alex-mous/Binary-Clock/README.md

# Binary (Base 2) Alarm Clock

### Conversion of a classic two-bell alarm clock into a futuristic binary (base 2) clock using a Circuit Playground Express and an Equity #13014
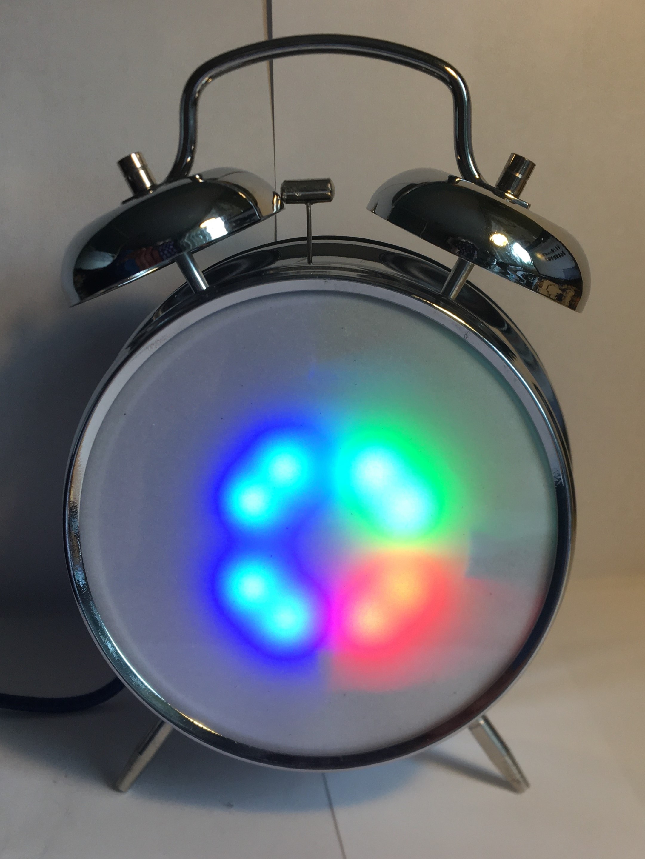
[picture p1: Assembly/10_40.JPG]
Completed Binary Clock project


### Parts and Materials
- Equity Two Bell Alarm Clock (#13014)
- 1Hz Timebase Circuit (taken from a clock circuit) - although I used a different circuit, you probably can adapt the one from the clock

- Circuit Playground Express
- Right-angle Micro USB to USB Type A Cable
- 5V USB Phone Charger
- Electronic components and wire as shown in the [wiring diagram](/Assembly/Wiring.pdf) and [BOM](/Assembly/BOM.csv)
- Files, screwdrivers, and soldering equipment
- Double sided tape and glue
- Three circle of vellum paper the same size as the alarm clock's face (3 13/16 inches)

### Software Setup
To setup your Circuit Playground Express, please see the Adafruit website. For this project, you will need to be able to upload code to it via the Arduino IDE.

Open the file main.ino in Arduino and upload it to the Circuit Playground Express.

### Hardware Setup

#### Disassembly
Dismantle the alarm clock by removing the screws on the back as shown in the picture below. Then continue to remove parts from it until only the metal shell is left. Also, desolder the connections to the clock mechanism and put it aside, marking which wires are for positive, negative and signals; we will be using it later to connect.

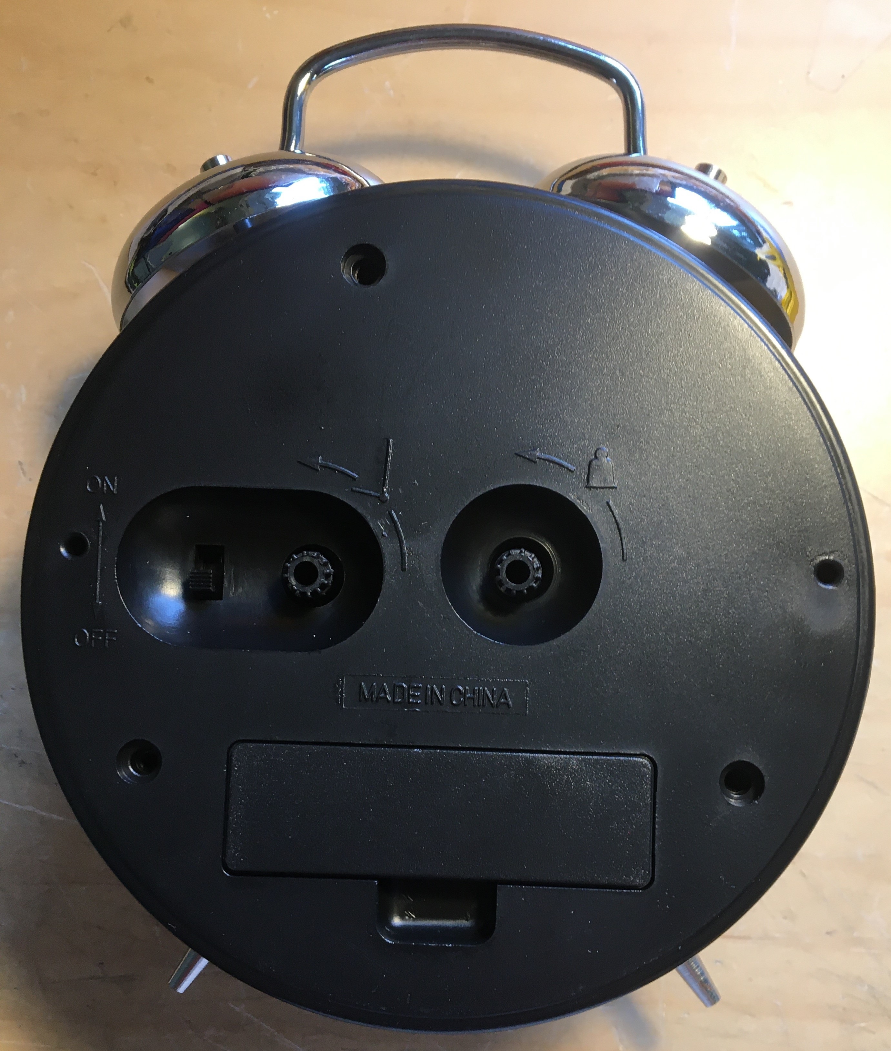
[picture p2: Assembly/Back_before.JPG]
Filed area out of the back of the case


There's an excellent guide on iFixit if you need more complete instructions for [disassembling it](https://www.ifixit.com/Guide/Equity+Alarm+Clock+13014+Clock+Hands+Replacement/33113).

#### Modifications
You will need to file the inner case to make it large enough so that the wires will all fit easily. Also, it is helpful to file a slot for the USB cable to go through in the front of the main plastic part. Finally, create a hole in the back of the case for the USB cable. Please see the picture below for where and how much to remove:

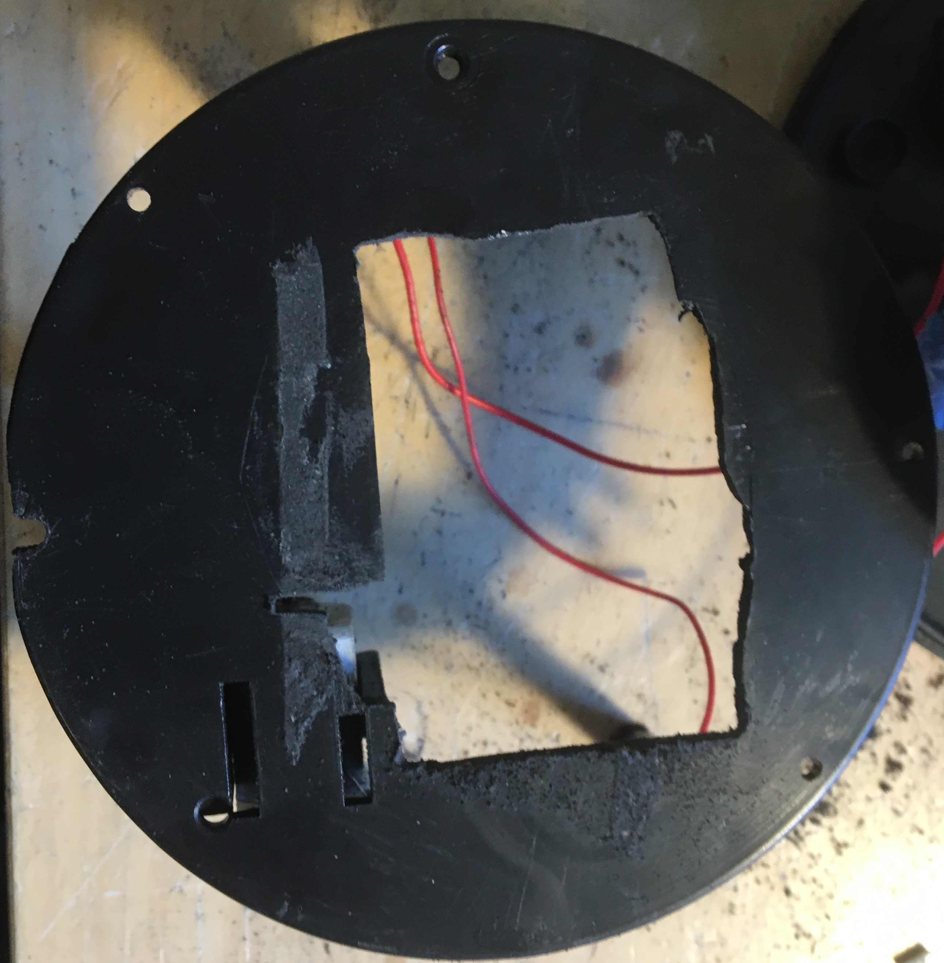
[picture p3: Assembly/Filed_back.JPG]
Filed area out of the back of the case


#### Creating the Timer Circuit
To create the timer circuit, first disassemble the clock case (there are three tabs that you'll need to pry up to get the lid off). Then remove the gears and other parts until you have the circuit separated.

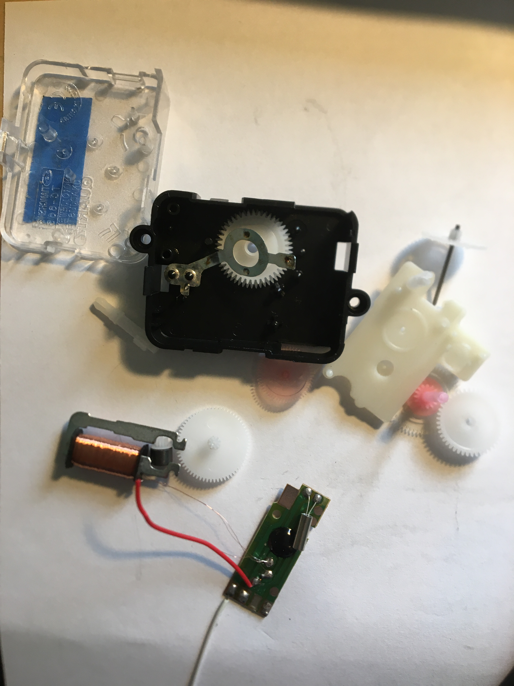
[picture p4: Assembly/Clock_circuit_disassembled.JPG]
Clock unit disassembled with gears and circuit removed


Next, solder up the circuit at shown in the wiring diagram with the connections highlighted below to the left. The diodes need to be connected to the coil output, and the power wires need to be connected to the resistors:

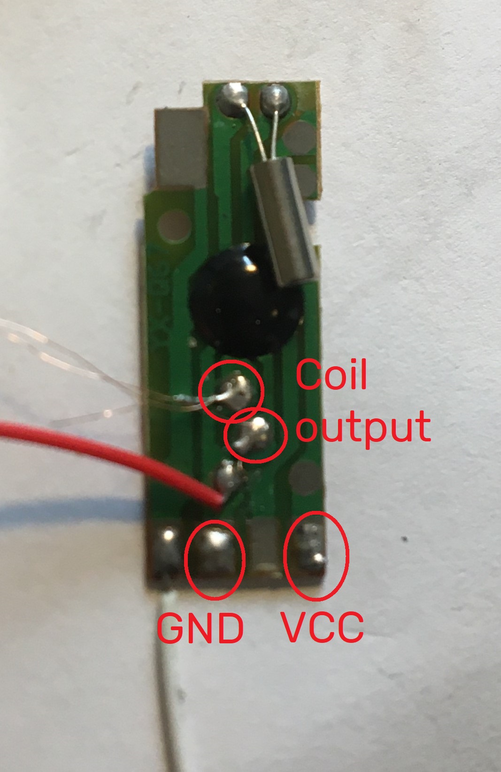
[picture p5: Assembly/Clock_circuit_adapted_new.JPG]
Clock circuit with adaptations
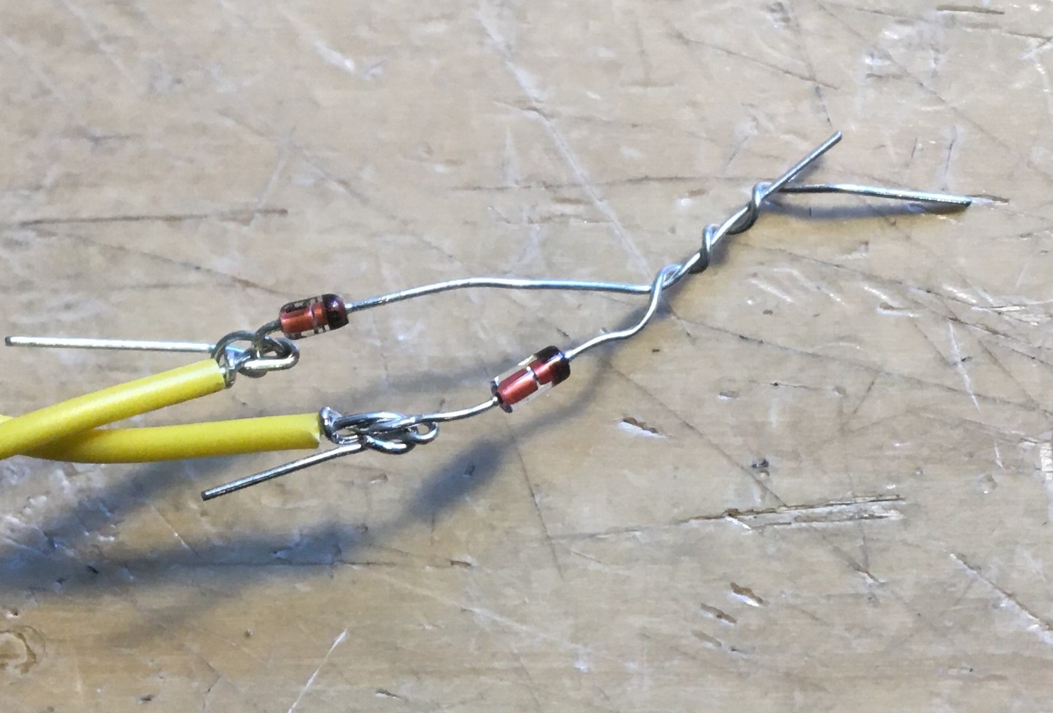
[picture p6: Assembly/Clock_circuit_output.JPG]
Clock circuit pulse output connection
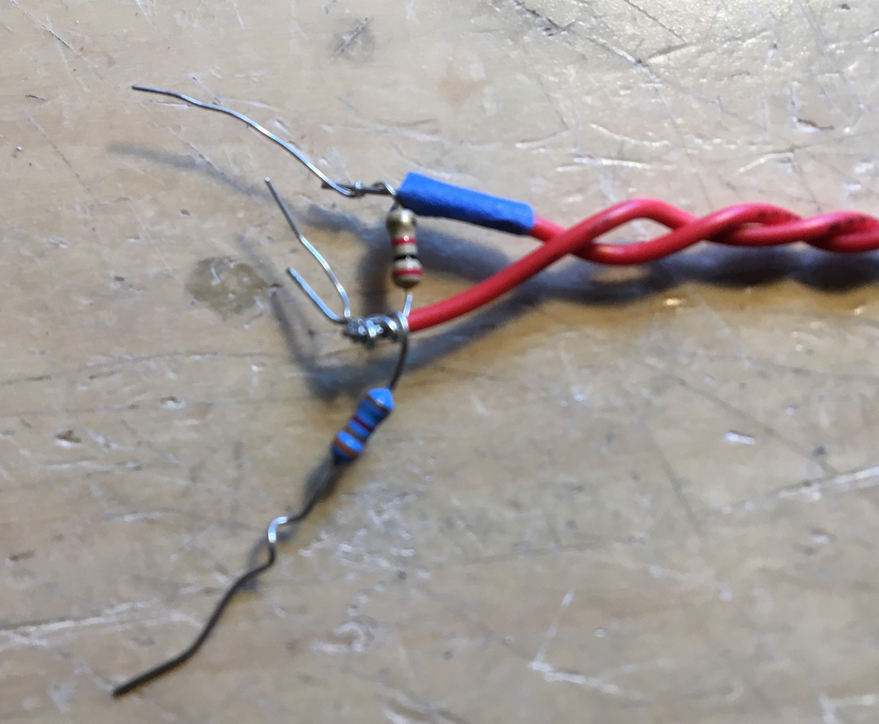
[picture p7: Assembly/Clock_circuit_voltage_supply.JPG]
Clock circuit voltage input lines


#### Wiring
Solder together the Circuit Playground Express board as shown below (reference the pictures with the <a href="/Assembly/Wiring.pdf">Wiring diagram</a>)

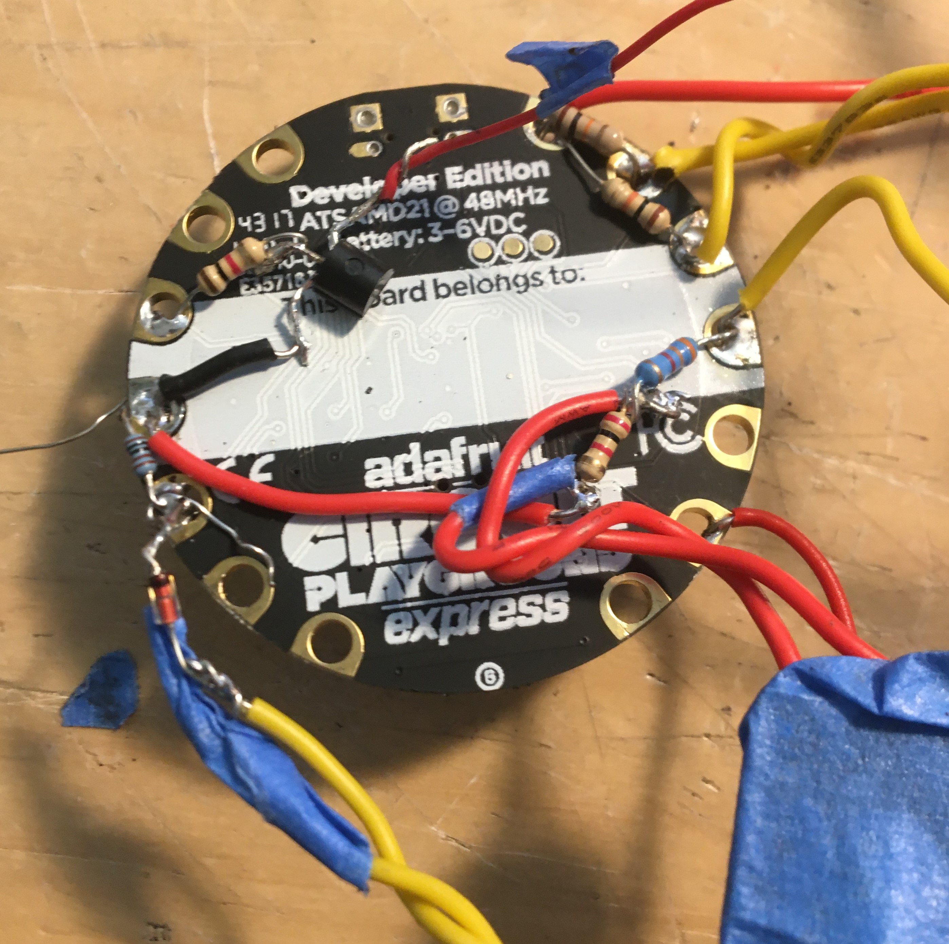
[picture p8: Assembly/Wired_circuit_board.JPG]
Circuit Playground Express component wiring


Next, glue in the switches as shown below and solder them up.

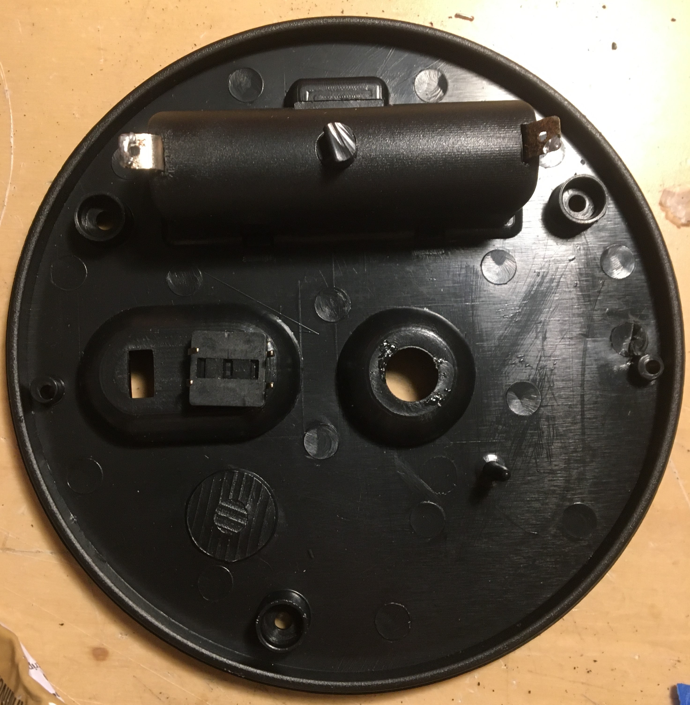
[picture p9: Assembly/Glueing_switches.JPG]
Glue the buttons into place
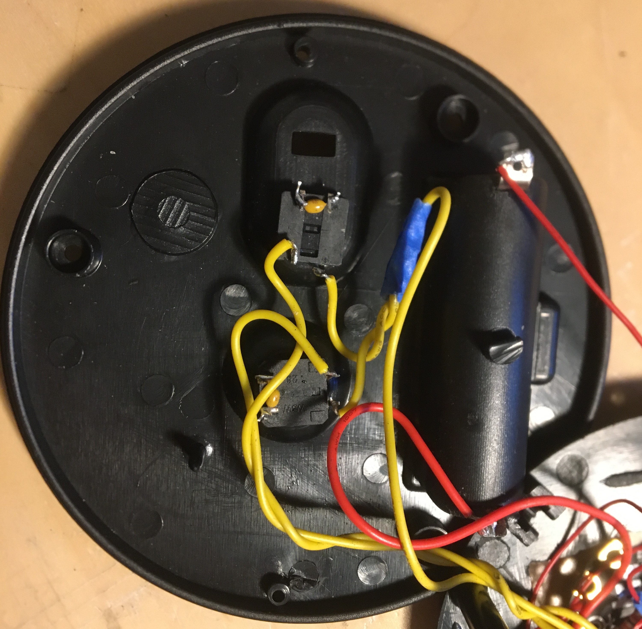
[picture p10: Assembly/Switch_wiring.JPG]
Buttons wiring to the main circuit


Then, solder up the motor and alarm switch using the original wire.

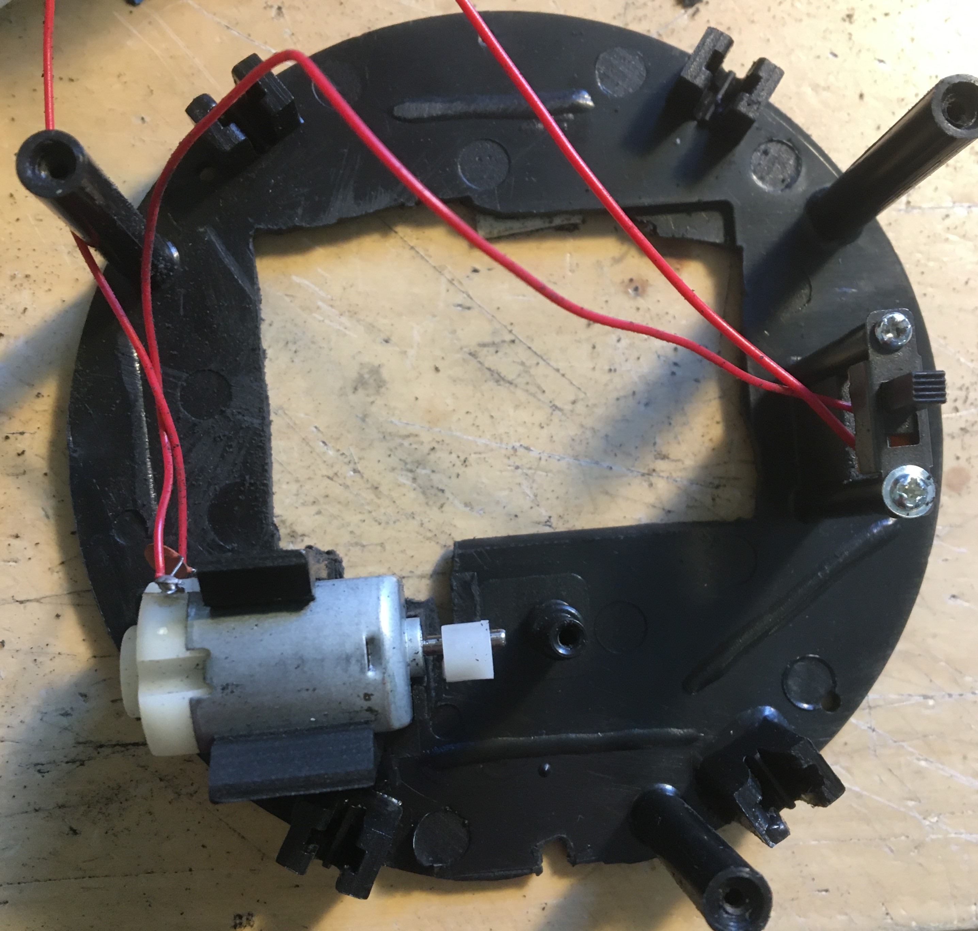
[picture p11: Assembly/Motor_wiring.JPG]
Motor wiring


Finally, solder up the rest of the project as shown below and in the wiring diagram.

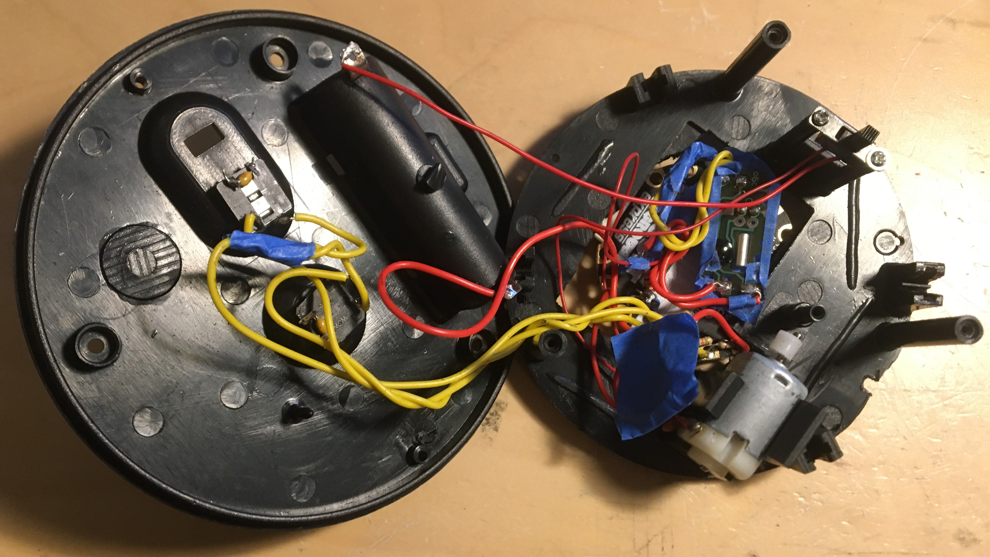
[picture p12: Assembly/Complete_circuit_installed.JPG]
Circuit completely assembled


#### Final Assembly
Now attach the Circuit Playground Express to the front with double sided tape. Plug in the USB cable, and route it through the case and out the hole in the back.

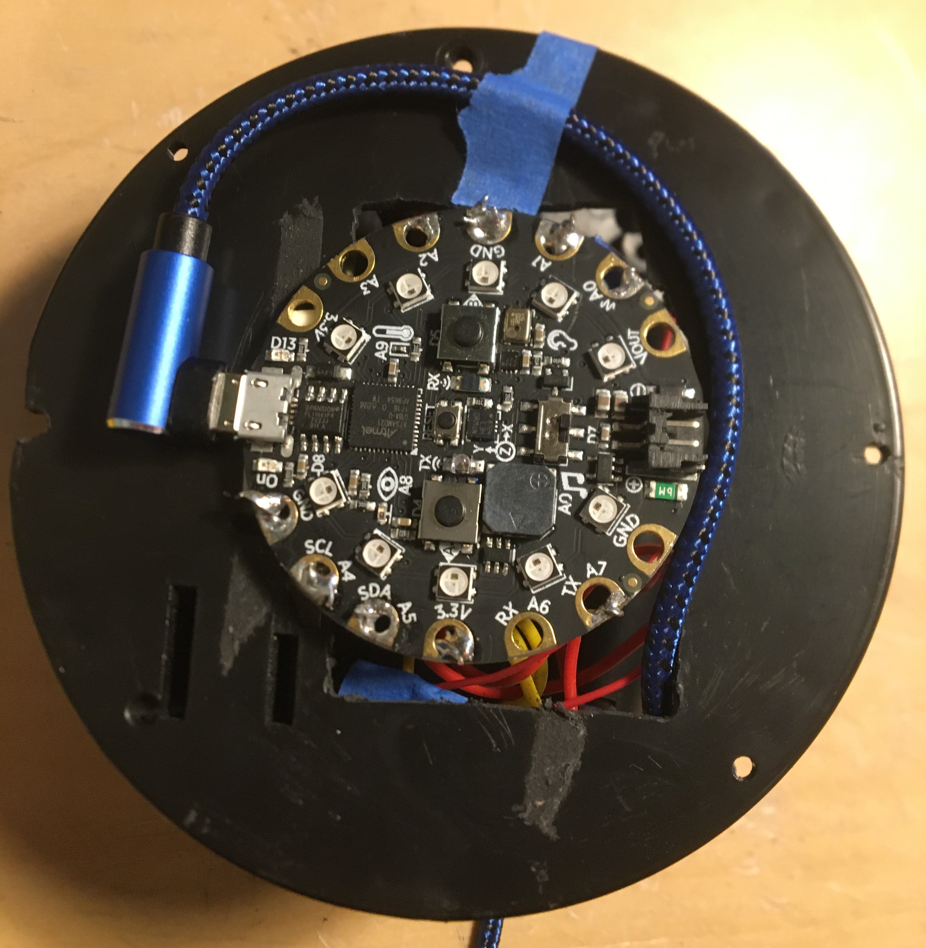
[picture p13: Assembly/Circuit_playground_express_installed.JPG]
Circuit Playground Express installed with cables connected


Place the three circles of vellum on the glass, and put the assembly inside of the metal case.

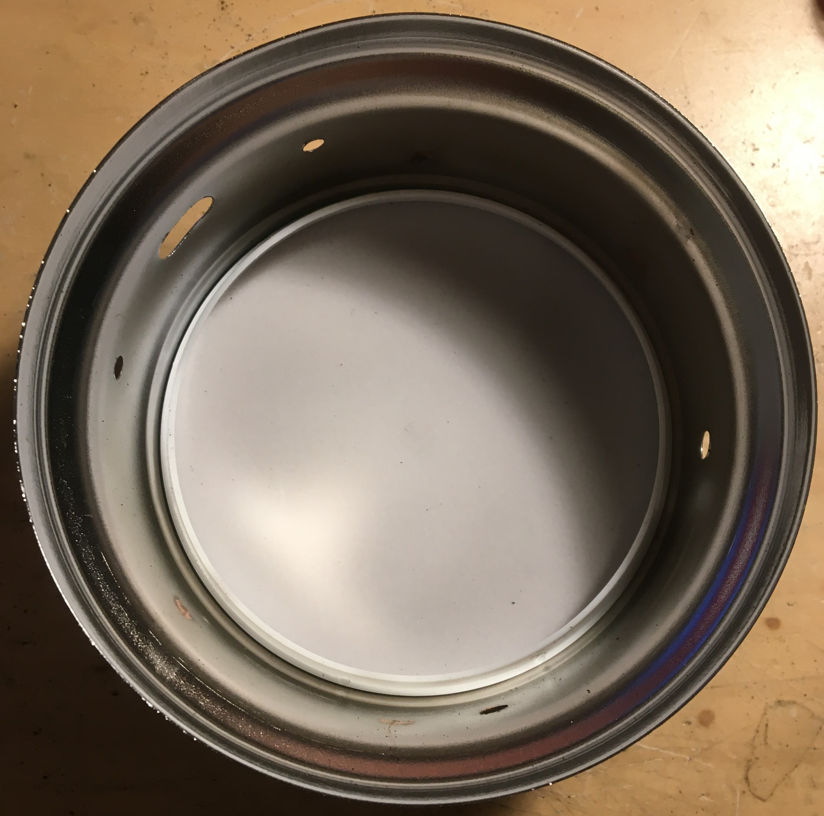
[picture p14: Assembly/Front_inside.JPG]
Front inside of the case with vellum paper installed


As an additonal step, the cover plate for the battery can be reused to cover up the battery and provide some support for the wire. To do this, file a hole into it as shown below.

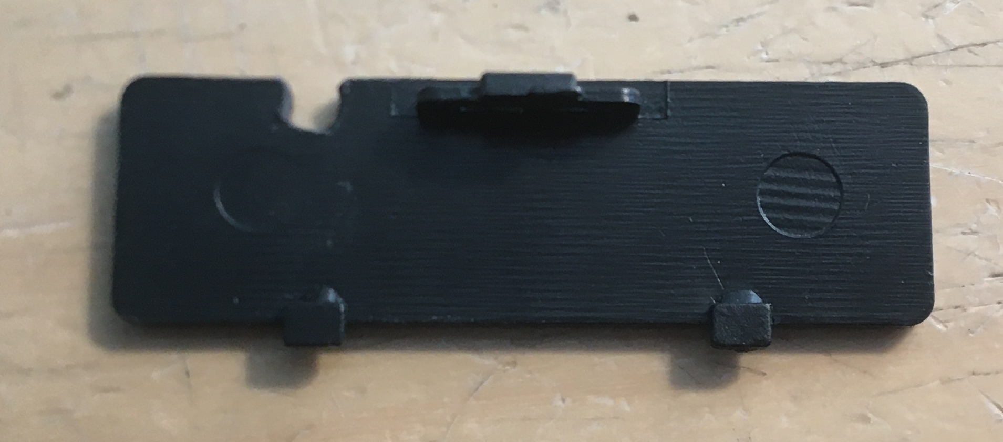
[picture p15: Assembly/Battery_cover.JPG]
Modified cover for the battery compartment


Reassemble the clock as it was taken apart, making sure no wires are trapped in the mechanism. Finally, add some labels to make the clock usable, and the clock is finished!

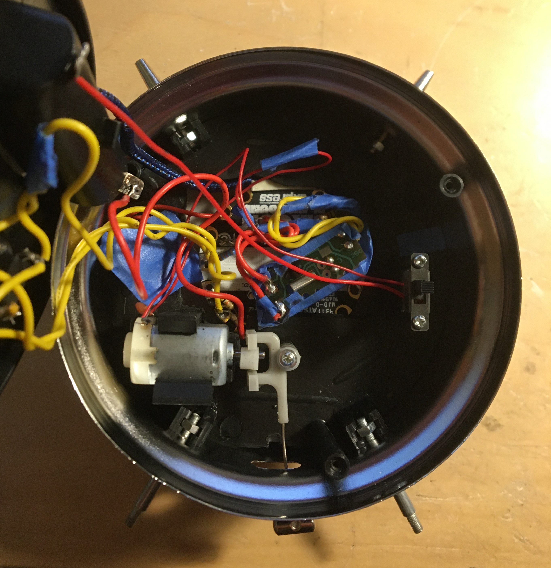
[picture p16: Assembly/Front_panel_installed.JPG]
Electronics all added and ready to place on the back of the case
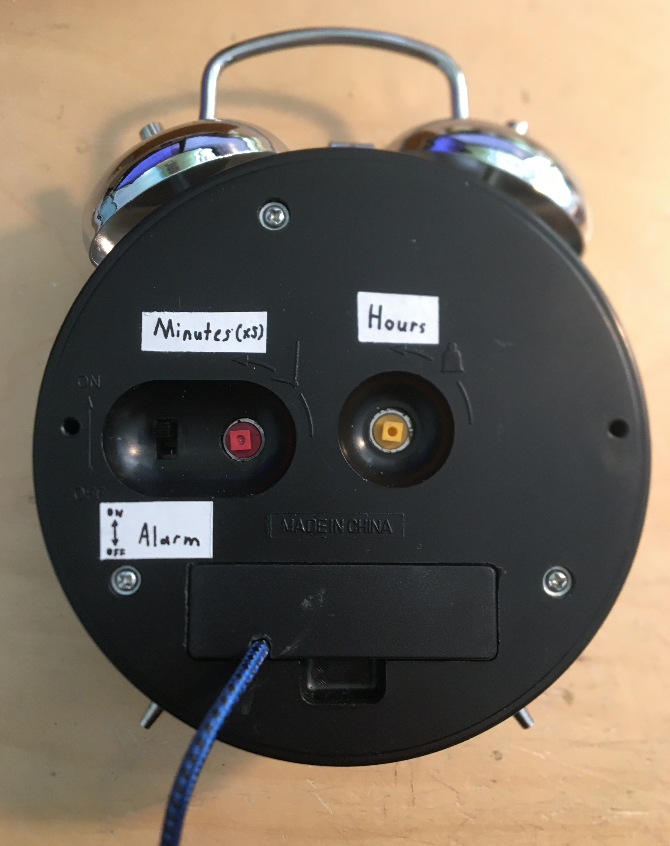
[picture p17: Assembly/Back_after_labelled.JPG]
Back of the finished and fully assembled clock


### Usage

#### Reading the clock
The clock displays numbers in a binary pattern, with the top-left quadrant representing 1 and the bottom-right quadrant representing 8. The values increase in powers of two from left to right:
| Clock | quadrants |
| --- | --- |
|  1  |  2  |
|  4  |  8  |

| 8:35 | 10:40 | 11:30 | 17:55 |
|:----:|:-----:|:-----:|:-----:|
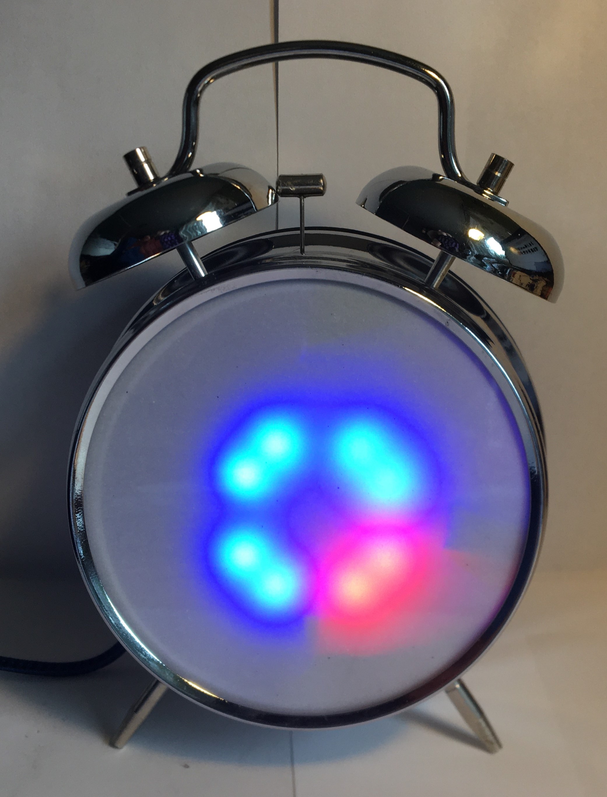
[picture p18: Assembly/8_40.JPG]
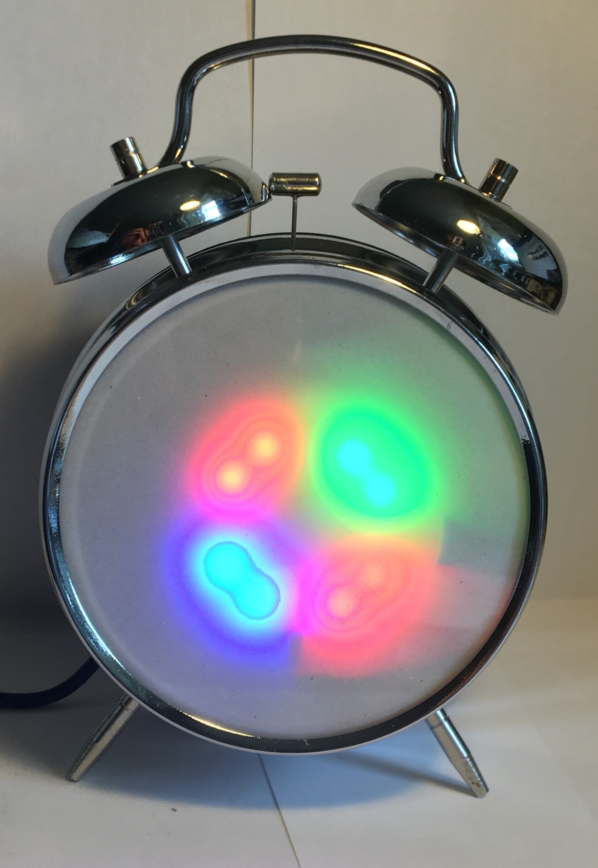
[picture p19: Assembly/11_30.JPG]
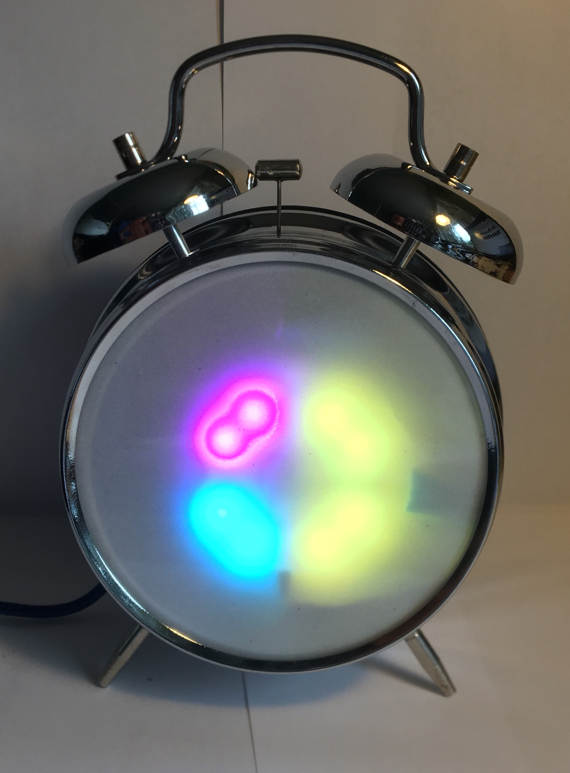
[picture p20: Assembly/17_55.JPG]
|  |  |  |  |

The colors represent the hours, minutes or both. The mnemonics RGB and CMY can be used to remeber which color is which time - red and cyan are hours, green and magenta are both, and blue and yellow are minutes. RGB is used for AM, whereas CMY represents PM.

#### Setting and resetting the time and alarm
Please see the table below for the various functions available. The change the times (current or alarm), first enter the time setting mode as instructed below. Then use the two buttons to increment the hours and minutes.

| Action | Function |
|---|---|
| Both buttons, 1 second | Set the current time (LEDs flash green) |
| Both buttons, 2-3 seconds | Set the alarm time, (LEDs flash blue) |
| Both buttons, 4 seconds | Reset all times to their default (disables the alarm; LEDs flash red) |
| Either buttons, 1 second | Briefly raise the brightness of the clock (or turn on the clock's brigthness at night) |

#### Extra Functionalities
The switch on the back is provided to disable the alarm. Keep in mind that this is connected directly to the motor, so the alarm will not sound again until you flip the switch back. Also, a night mode is provided where the LEDs are off by default and only turn on briefly when either button is pressed. The default time when this is active is from 23:00 hours until 7:00 - these settings can be changed in the main.ino file (under NIGHT_START and NIGHT_STOP).

### License
Copyright (C) 2020  PolarPiBerry
All work is licensed under the GNU General Public License (see LICENSE)
