alex-mous/Binary-Clock/Assembly/Wiring.pdf

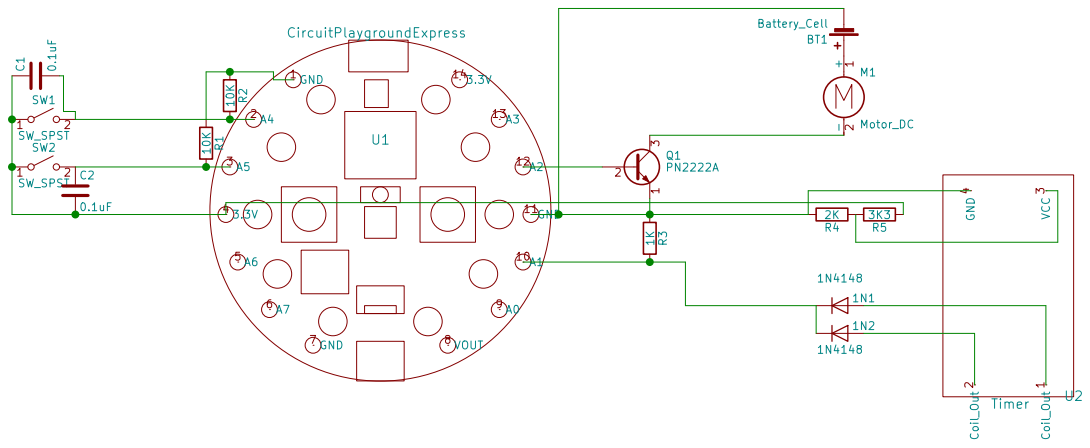
[picture p21: page 1]
