alex-mous/Binary-Clock/(commit log)

2020-03-30 Add pictures, wiring diagram and BOM
    [BOM.csv]
2020-03-30 Add buttons
    [BOM.csv]
2020-07-05 Add images of new back and cover plate
